Alilashari/AWF-Generator/Electrical/BOM.xlsx

RefDes | Value | Size | Quantity | Boards | Final Quantity | Price per Unit | Total price | Link
C1, C3, C6,C9,C13,C16 | 10pf | 1206 | 6 | 2 | 14 | 0.603 | 8.442 | http://www.digikey.ca/product-detail/en/murata-electronics-north-america/GRM31A7U3D100JW31D/490-6501-1-ND/3845698
C5, C8, C11, C12, C15, C18 | 5pf | 1808 | 6 | 2 | 14 | 0.69 | 9.66 | http://www.digikey.ca/product-detail/en/murata-electronics-north-america/GRM42A5C3F050DW01L/490-6546-1-ND/3845743
J1..J13 | BNC Con |  | 13 | 2 | 28 | 2.265 | 63.42 | http://www.digikey.ca/scripts/DkSearch/dksus.dll?Detail&itemSeq=196951710&uq=635987624896542168
Q1..Q12 | NMOS | BSS127S-7 | 12 | 2 | 26 | 0.366 | 9.516 | http://www.digikey.ca/product-detail/en/diodes-incorporated/BSS127S-7/BSS127S-7DICT-ND/3451564
R1..R12 | 120K | 2512 | 48 | 2 | 100 | 0.381 | 38.1 | http://www.digikey.ca/scripts/DkSearch/dksus.dll?Detail&itemSeq=196945896&uq=635987625666789185
R13..R24 | 1M | 0805 | 12 | 2 | 26 | 0.16 | 4.16 | http://www.digikey.ca/product-detail/en/panasonic-electronic-components/ERJ-P06J105V/P1.0MADCT-ND/525440
R25..R36 | 10M | 0805 | 12 | 2 | 26 | 0.023 | 0.598 | http://www.digikey.ca/product-detail/en/yageo/RC0805JR-0710ML/311-10MARCT-ND/731189
U1, U4..U26 | Test Point | 0805 | 24 | 2 | 50 | 0.16 | 8 | http://www.digikey.ca/product-detail/en/te-connectivity-amp-connectors/RCT-0C/A106144CT-ND/3477801
U2, U3 | Logic Level Shifter | TXB0106 | 2 | 2 | 4 | 0 | 0 | www.ti.com/lit/ds/symlink/txb0106.pdf
U$1 | Teensy 3.2 |  | 1 | 2 | 2 | 30 | 60 | https://www.pjrc.com/teensy/teensy31.html
 |  |  |  |  |  |  | 201.896
