Alilashari/AWF-Generator/Electrical/schematic.pdf

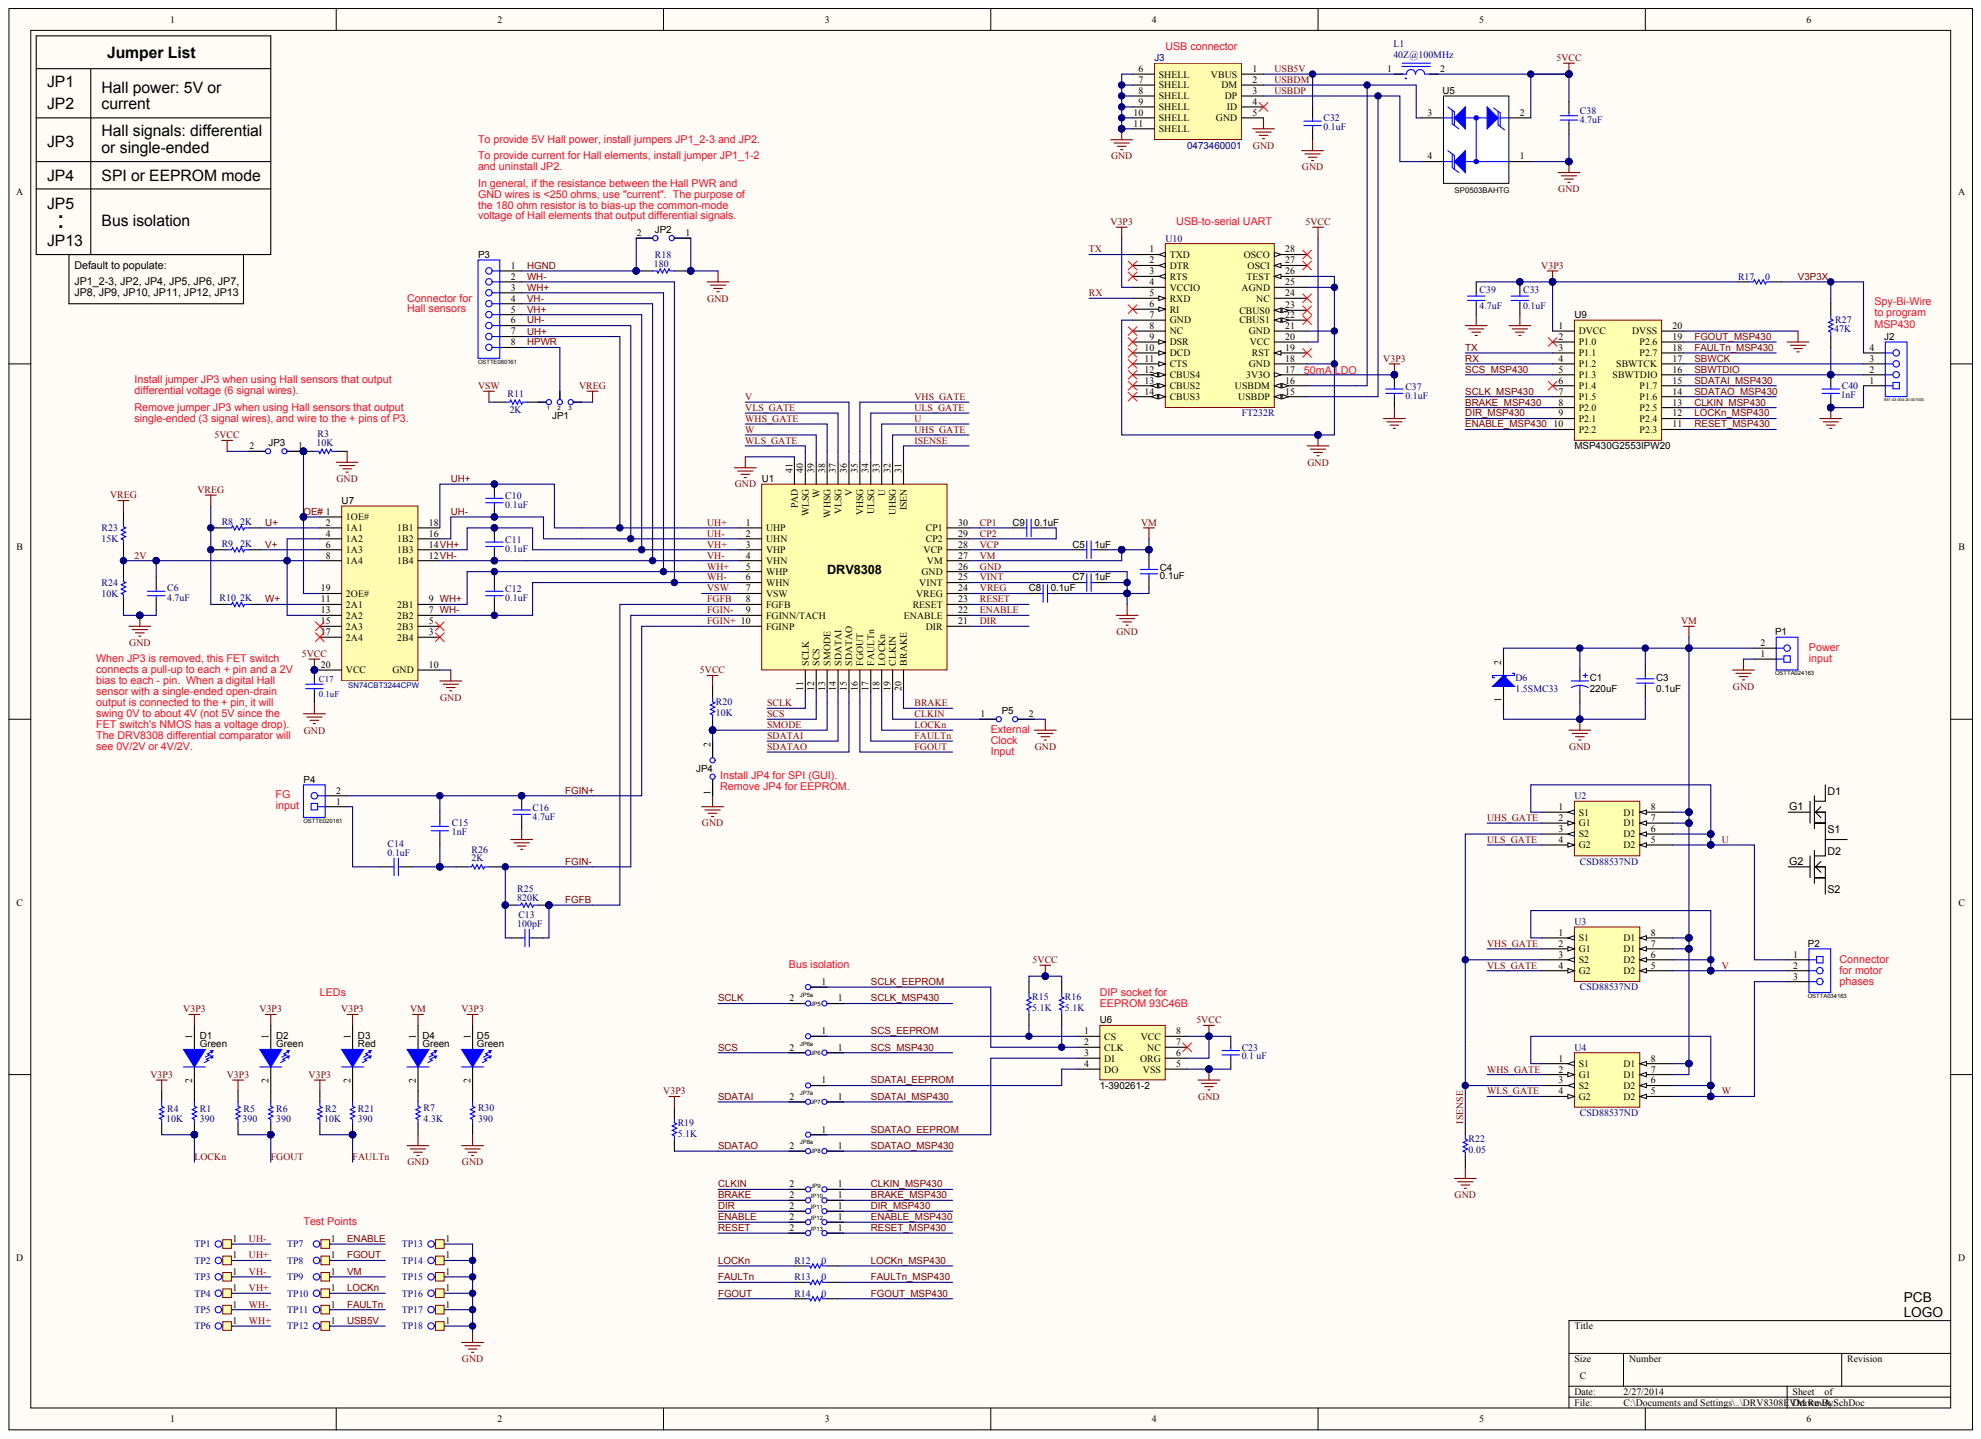
[picture p1: page 1]

To provide 5V Hall power, install jumpers JP1_2-3 and JP2.
To provide current for Hall elements, install jumper JP1_1-2
and uninstall JP2.
In general, if the resistance between the Hall PWR and
GND wires is <250 ohms, use "current". The purpose of
the 180 ohm resistor is to bias-up the common-mode
voltage of Hall elements that output differential signals.

USB-to-serial UART

Install jumper JP3 when using Hall sensors that output
differential voltage (6 signal wires).
Remove jumper JP3 when using Hall sensors that output
single-ended (3 signal wires), and wire to the + pins of P3.

CBUS2 13 | | | SCLK_MSP430 | P1.4 6 | SDATAI_MSP430 | 1

P1.5 7 | SDATAO_MSP430 | 1nF

ISEN 31 UHSG 32 U 33 ULSG 34 VHSG 35 V 36 VLSG 37 WHSG 38 W 39 WLSG 40 PAD 41
GND

1A3 6 | | VH+ | | VH+ | VHP 3 | VCP
1A4 8 | VH- | | VH- | VHN 4 | VM

W+ | | | | 2OE# 19 | | WH+ | WHP 5 | GND

WH+ | VSW | VSW 7 | | VREG C8 | 0.1uF

WH- | WHN 6 | | VINT C7 | 1uF

When JP3 is removed, this FET switch
connects a pull-up to each + pin and a 2V
bias to each - pin. When a digital Hall
sensor with a single-ended open-drain
output is connected to the + pin, it will
swing 0V to about 4V (not 5V since the
FET switch's NMOS has a voltage drop).
The DRV8308 differential comparator will
see 0V/2V or 4V/2V.

10K | SCS | | CLKIN

SMODE | | LOCKn
SDATAI | | FAULTn
SDATAO | FGOUT

Install JP4 for SPI (GUI).
Remove JP4 for EEPROM.

FGFB
