Alilashari/AWF-Generator/Electrical/PCB Layout Back.pdf

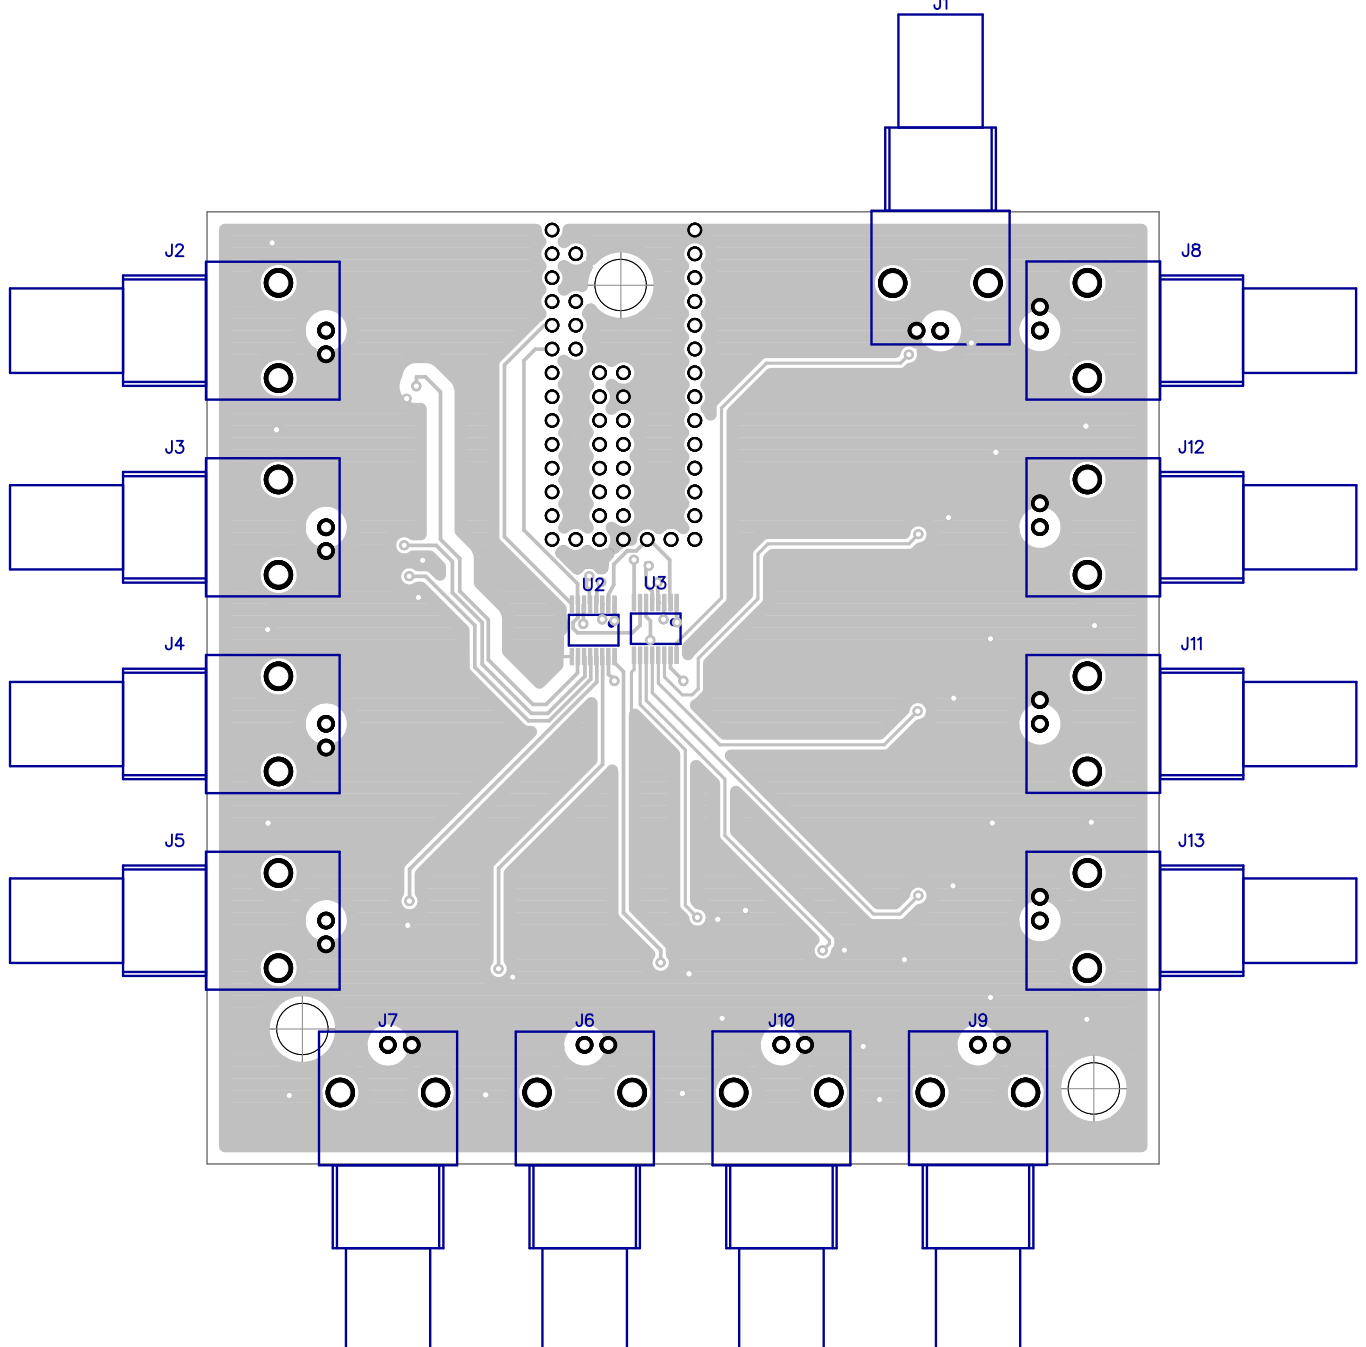
[picture p2: page 1]
