Alilashari/AWF-Generator/Electrical/PCB Layout.pdf

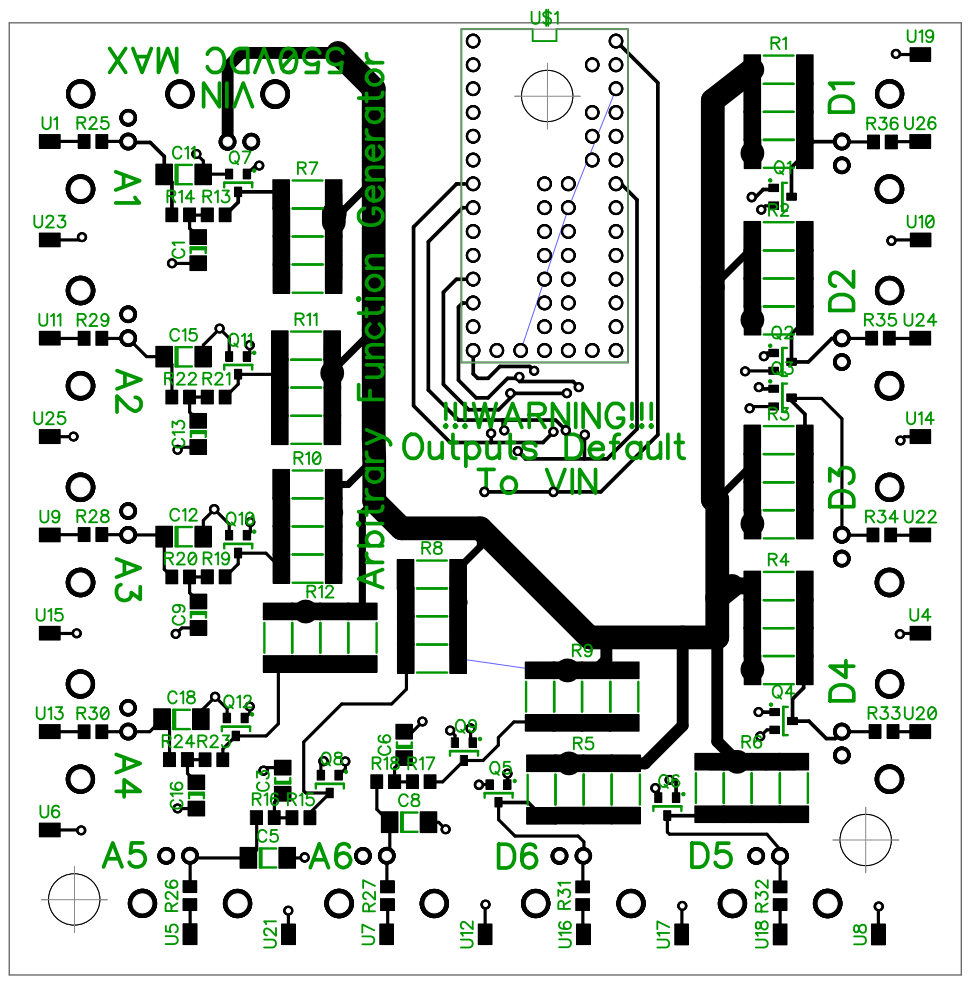
[picture p3: page 1]
