Alilashari/AWF-Generator/(list of files, drawings)

Other design files:
Electrical/AWFG.dch
Electrical/AWFG.dip
