Alilashari/AWF-Generator/AWFG/WF.h

int wave[]{128,128,128,128,128,128,128,128,
129,129,129,129,129,129,129,129,
130,130,130,130,130,130,130,130,
131,131,131,131,131,131,131,131,
132,132,132,132,132,132,132,132,
133,133,133,133,133,133,133,134,
134,134,134,134,134,134,134,135,
135,135,135,135,135,135,135,136,
136,136,136,136,136,136,136,137,
137,137,137,137,137,137,137,138,
138,138,138,138,138,138,139,139,
139,139,139,139,139,139,140,140,
140,140,140,140,140,140,141,141,
141,141,141,141,141,141,142,142,
142,142,142,142,142,142,143,143,
143,143,143,143,143,143,144,144,
144,144,144,144,144,144,145,145,
145,145,145,145,145,146,146,146,
146,146,146,146,146,147,147,147,
147,147,147,147,147,148,148,148,
148,148,148,148,148,149,149,149,
149,149,149,149,149,150,150,150,
150,150,150,150,150,151,151,151,
151,151,151,151,151,152,152,152,
152,152,152,152,152,153,153,153,
153,153,153,153,153,154,154,154,
154,154,154,154,154,155,155,155,
155,155,155,155,155,156,156,156,
156,156,156,156,156,157,157,157,
157,157,157,157,157,158,158,158,
158,158,158,158,158,159,159,159,
159,159,159,159,159,160,160,160,
160,160,160,160,160,161,161,161,
161,161,161,161,161,162,162,162,
162,162,162,162,162,163,163,163,
163,163,163,163,163,164,164,164,
164,164,164,164,164,165,165,165,
165,165,165,165,165,165,166,166,
166,166,166,166,166,166,167,167,
167,167,167,167,167,167,168,168,
168,168,168,168,168,168,169,169,
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

int N1O[]={0,1,0,1};
int N2O[][2]={{0,1},{1,0}};
int N3O[][3]={{0,1,1},{1,0,1},{1,1,0}};
int N4O[][4]={{0,1,1,1},{1,0,1,1},{1,1,0,1},{1,1,1,0}};
int N5O[][5]={{0,1,1,1,1},{1,0,1,1,1},{1,1,0,1,1},{1,1,1,0,1},{1,1,1,1,0}};
int N6O[][6]={{0,1,1,1,1,1},{1,0,1,1,1,1},{1,1,0,1,1,1},{1,1,1,0,1,1},{1,1,1,1,0,1},{1,1,1,1,1,0}};



int W3O[][3]={

{0,1,0},
{0,1,1},
{0,0,1},
{1,0,1},
{1,0,0},
{1,1,0}
  
  };


int W4O[][4]={

{0,1,1,0},
{0,1,1,1},
{0,0,1,1},
{1,0,1,1},
{1,0,0,1},
{1,1,0,1},
{1,1,0,0},
{1,1,1,0}
  
  };

int W5O[][5]={

{0,1,1,1,1},
{0,0,1,1,1},
{1,0,1,1,1},
{1,0,0,1,1},
{1,1,0,1,1},
{1,1,0,0,1},
{1,1,1,0,1},
{1,1,1,0,0},
{1,1,1,1,0},
{0,1,1,1,0}
  };

int W6O[][6]={

{0,1,1,1,1,1},
{0,0,1,1,1,1},
{1,0,1,1,1,1},
{1,0,0,1,1,1},
{1,1,0,1,1,1},
{1,1,0,0,1,1},
{1,1,1,0,1,1},
{1,1,1,0,0,1},
{1,1,1,1,0,1},
{1,1,1,1,0,0},
{1,1,1,1,1,0},
{0,1,1,1,1,0}
  };
